dannykha/Auto-Ranging-Ohmmeter/README.md

This is documentation on an Ohmmeter project that was designed by Max Kelton, programmed by Danny Kha, and built and tested together by both Max and Danny.



Cute looking PCB that was made with <3 by JLCPCB
